enthdegree/120-film-on-a-plustek8100/images/bench_small.jpg

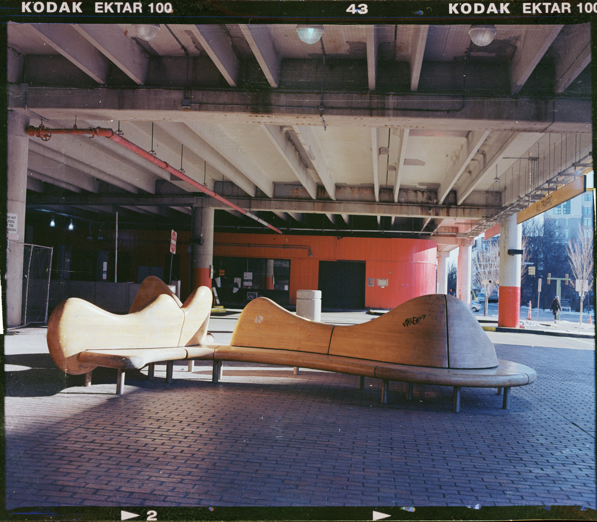
images/bench_small.jpg
