enthdegree/120-film-on-a-plustek8100/images/darktable screenshot.png

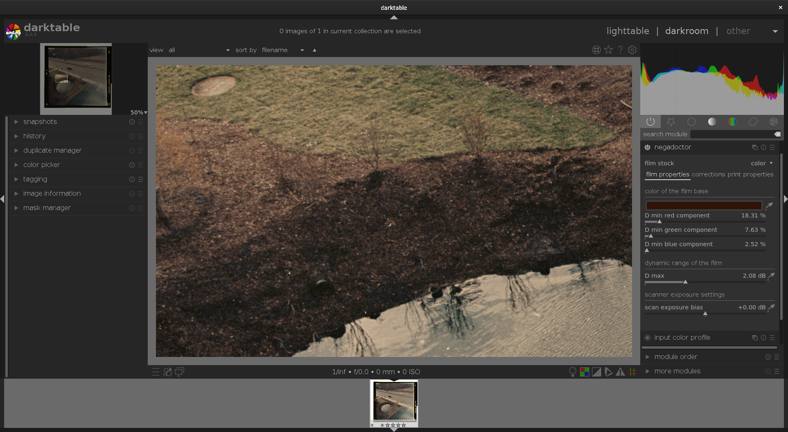
images/darktable screenshot.png
