enthdegree/120-film-on-a-plustek8100/images/gimp merge.png

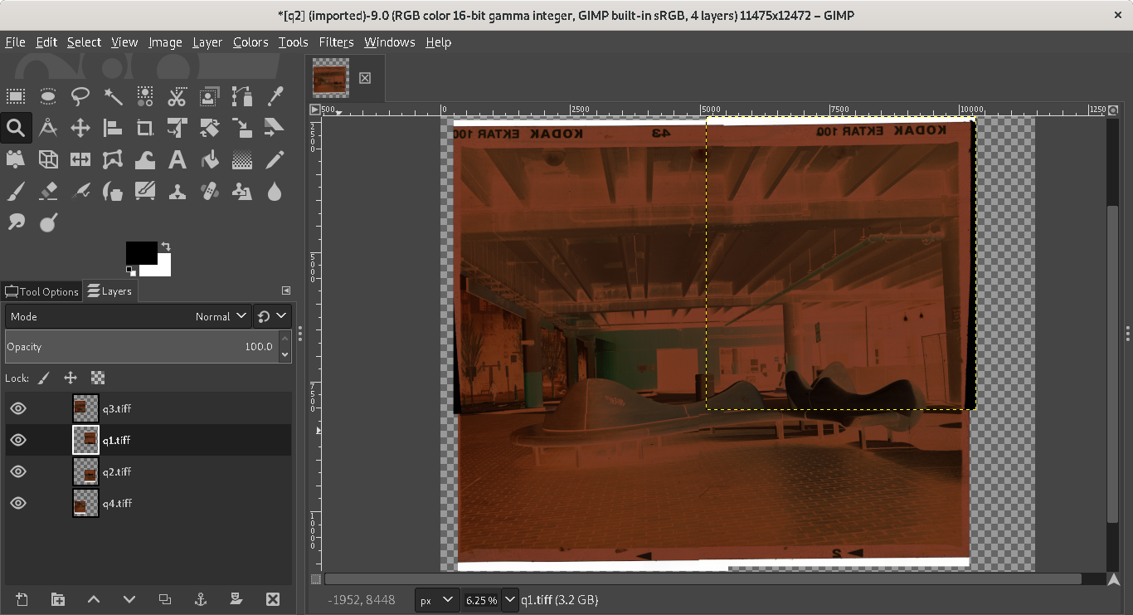
images/gimp merge.png
