enthdegree/120-film-on-a-plustek8100/images/sketches.jpg

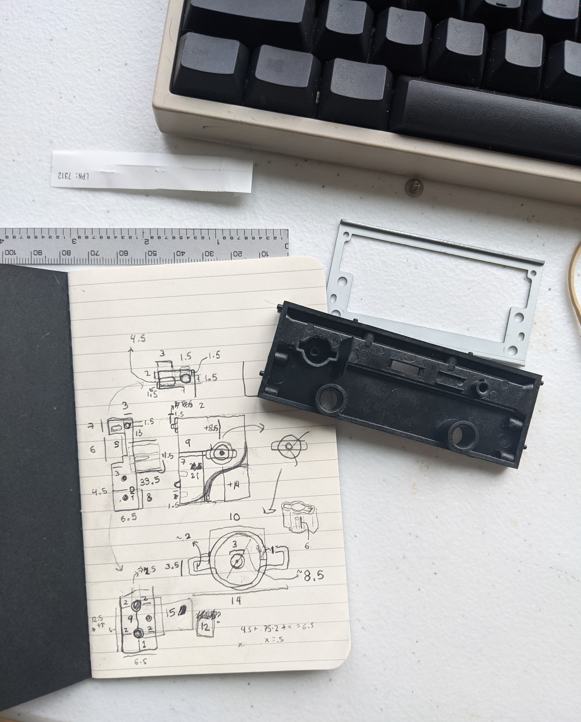
images/sketches.jpg
