enthdegree/120-film-on-a-plustek8100/parts/plustek120_carriage.FCStd

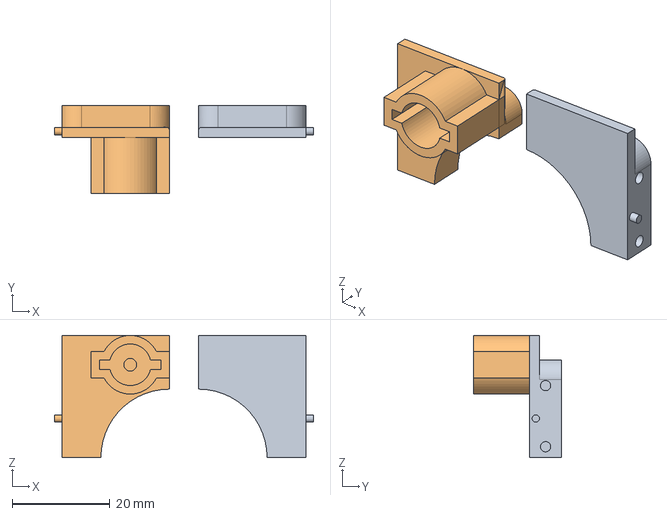
[picture p14: CAD file, 2025-01-24]
parts/plustek120_carriage.FCStd
53.0 x 18.0 x 25.0 mm
Fillet001 (Mirror #1)
