enthdegree/120-film-on-a-plustek8100/parts/plustek120_rightcarriage.stl

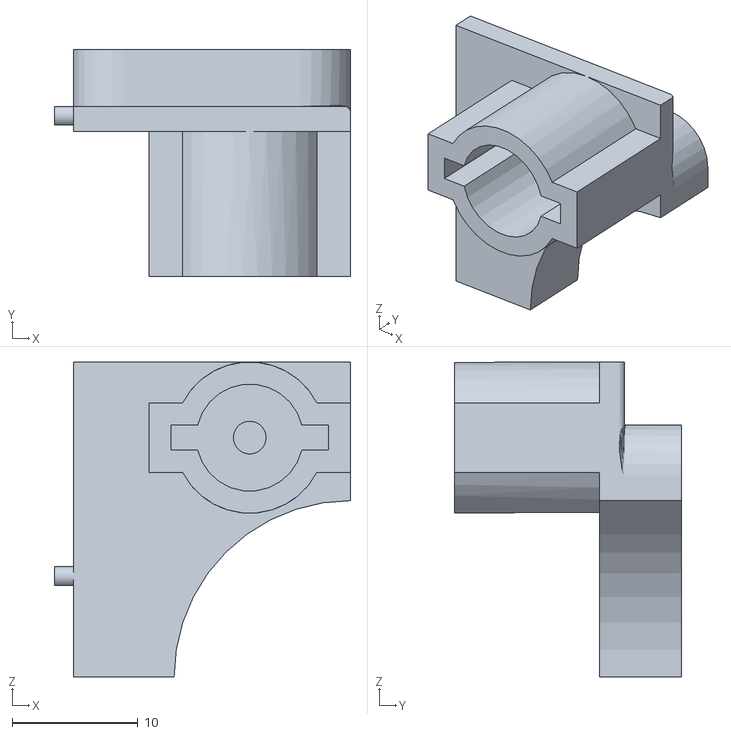
[picture p15: CAD file, 2025-01-24]
parts/plustek120_rightcarriage.stl
23.5 x 18.0 x 25.0
