enthdegree/120-film-on-a-plustek8100/parts/plustek120_tray.FCStd

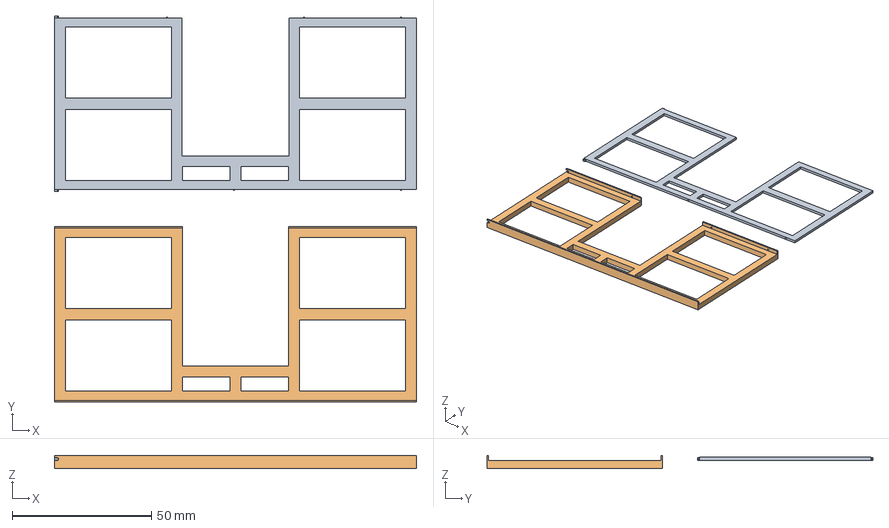
[picture p16: CAD file, 2025-01-24]
parts/plustek120_tray.FCStd
130.0 x 138.6 x 4.50 mm
cutcover
