enthdegree/120-film-on-a-plustek8100/parts/plustek120_leftcarriage.stl

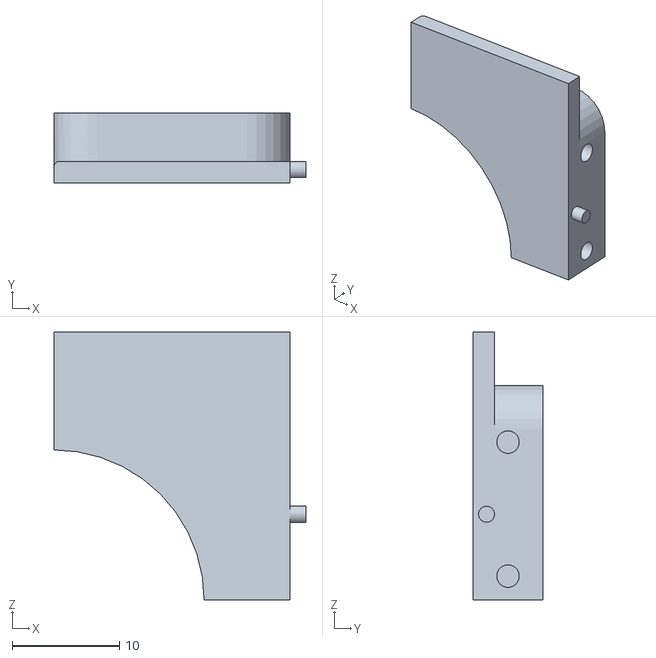
[picture p17: CAD file, 2025-01-24]
parts/plustek120_leftcarriage.stl
23.5 x 6.50 x 25.0
