enthdegree/120-film-on-a-plustek8100/(list of files, cad)

Other CAD files:
parts/plustek120tray.stl
